theforces/Audio-Power-Amplifier/Layout/Layout.JPG

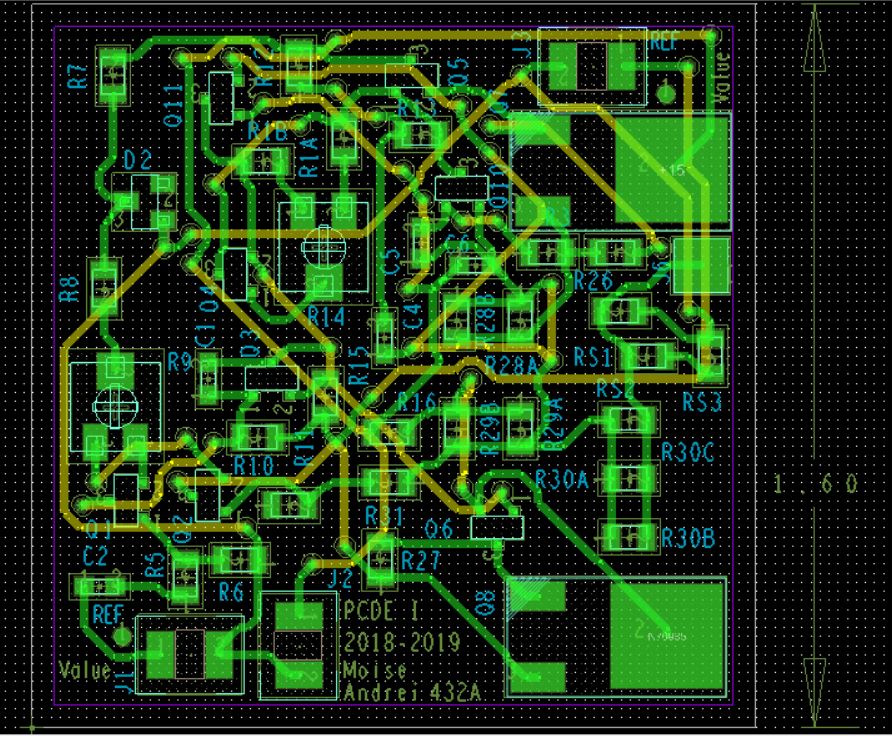
Layout/Layout.JPG
