theforces/Audio-Power-Amplifier/README.md

# Audio-Power-Amplifier

Faculty Project in Electronics.
