theforces/Audio-Power-Amplifier/Proiect.docx

PROIECT 1 – DISPOZITIVE ȘI CIRCUITE ELECTRONICE

MOISE ANDREI

432A

###### Cuprins

###### Capitolul 2

#### AMPLIFICATOR AUDIO DE PUTERE

  1. Tema de proiectare...............................................................................1
  2. Seturi de date de intrare........................................................................2
  3. Etajul final............................................................................................3
  4. Etajul pilot..........................................................................................10
  5. Etajul diferenţial.................................................................................14
  6. Reacţia negativă.................................................................................17
  7. Lista componentelor şi schema electrică...........................................18
  8. Analiza AC Sweep.............................................................................21
  9. Analiza Time Domain........................................................................22
  10. Analiza PSF........................................................................................23
  11. Modelul PCB......................................................................................24

#### AMPLIFICATOR AUDIO DE PUTERE

Acest capitol prezintă principalele aspectele ale proiectării amplificatoarelor audio de putere. Se porneşte de la o temă de proiectare care stabileşte schema bloc a amplificatorului şi principalii parametri ai amplificatorului. După proiectarea etajului final, pilot, diferenţial, a protecţiei termice şi la scurtcircuit sunt analizate stabilitatea şi amplificarea stabilită de reţeaua de reacţie negativă.

1 TEMA DE PROIECTARE

Tema de proiectare se referă la un amplificator de audiofrecvenţă de mare putere realizat dintr-un etaj de ieşire în clasă B polarizat cu ajutorul etajului pilot care lucrează în clasă A. Pentru asigurarea unui curent mare de ieşire tranzistoarele finale sunt realizate din două tranzistoare în conexiune darlington.

Amplificarea în tensiune şi adaptarea cu sursa de semnal de intrare este realizată cu ajutorul etajului de intrare de tip diferenţial care lucrează de asemenea în clasă A. Amplificarea globală a amplificatorului este stabilită prin intermediul reacţiei negative.

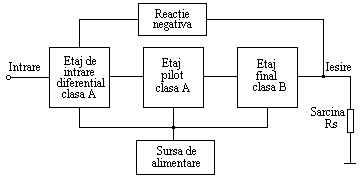
[picture p3: figure]

Figura 2.1 Schema bloc a amplificatorului audio de putere

2 SETURI DE DATE DE INTRARE

Principalii parametri ai amplificatorului audio de putere sunt:

- Puterea nominală pe sarcină PS (W)
- Rezistenţa de sarcină Rs (Ω)
- Rezistenţa de intrare Ri (KΩ)
- Amplificarea în tensiune Au (-)

Sursa de alimentare va asigura următorii parametri:

- Curentul nominal Io (mA)
- Rezistenţa de ieşire Ro (Ω)
- Coeficientul de stabilizare
- Tensiunea de alimentare este 220Vac ± 10%

Tabelul 2.1 Seturi de date de intrare pentru proiectare

Nr. | Amplificator | | | | Sursa de alimentare
| PS (W) | Rs (Ω) | Ri (KΩ) | Au (-) | IoM (A) | RoM (Ω)
16 | 10 | 8 | 45 | 8 | - | -

3 ETAJUL FINAL

Este realizat cu două tranzistoare bipolare complementare în conexiune colector comun. Deoarece tehnologia bipolară este axată pe tranzistore de putere de tip npn şi pentru creşterea amplificării în curent a etajului final se utilizează pentru cele două tranzistoare finale de putere configuraţii darlington de tip npn şi pnp.

Figura 2.2 Configuraţie darligton de tip npn

Considerăm T5 şi T7 în regim activ normal RAN.

VBE = VBE5 + VBE7 > 0

>0 >0

=> RAN

VCE = VCE7 = VCE5 + VBE7 > 0

Pentru ICB0 = 0 =>

Ic = Ic5 + Ic7 = βF5 Ib5 + βF7 Ib7 = βF5 Ib5 + βF7 Ie5 =

= = =

= =

≈ ≈

Principalii parametri ai configuraţiei Darlington de tip npn sunt:

βF ≈ βF7 βF5 = mare avantaj

== mare avantaj

VCE, Saturaţie = VCE2, Saturaţie = nemodificată avantaj

VBE = 2VBE5 = 2VBE7 = mare dezavantaj

Figura 2.3 Configuraţie darligton de tip pnp

Considerăm T1 şi T2 in RAN.

VEB = VEB6 > 0

=> RAN

VEC = VCE8 = VEC6 + VBE8 > 0

Pentru ICB0 = 0 =>

IC = IE8 = ( βF8 + 1 ) IB8 = ( βF8 + 1 ) IC6 =

= ( βF8 + 1 ) βF6 IB6 = ( βF8 + 1 ) βF6 IB

βF = (I_C)/(I_B) = ( βF8 + 1 ) βF6 ≈ βF8 βF6

Principalii parametri ai configuraţiei Darlington de tip pnp sunt:

βF ≈ βF8 βF6 = mare avantaj

h11 = h116 = nemodificat avantaj

VEB = VEB6 = nemodificat avantaj

VEC = VCE8 = VEC6 + VBE8 = mare dezavantaj

Când T6 se saturează se pierde controlul lui IC6 prin IB6 iar IC6 se închide prin joncţiunea BE a lui T8 care rămâne în RAN. =>

VEC, Saturaţie = VECT6, Saturaţie + VBET8 = 0,2 + 0,6 = 0,8V

Tehnologia bipolară standard este orientată pe fabricarea tranzistoarelor de tip npn care au conducţie verticală şi au factorul de amplificare în curent βF = mare (100 ÷ 200). Tranzistoarele pnp sunt de tip lateral cu conducţie orizontală sau tranzistor de substrat cu condiţie verticală având βF mic.

În practică se folosesc configuraţiile darlington cu rezistenţă în paralel cu joncţiunea bază-emitor a tranzistorului bipolar de putere de tip npn (R26 şi R27). Rolul acestor rezistenţe este următorul:

- La funcţionarea în clasă „B” în repaus curentul prin T7 este mic iar curentul de baza va fi şi el mic. La curenţi mici de colector amplificarea în curent a tranzistoarelor are o cădere pronunţată Þ amplificarea este redusă Þ reacţia negativă va fi ineficientă asupra neliniarităţii curbei de transfer. La îmbinarea caracteristicilor tranzistoarelor complementare apar distorsiuni de trecere (cross-over) şi pentru micşorarea acestora se face o polarizare iniţială în regim static al tranzistoarelor. Rezistenţa R26 măreşte curentul de colector al tranzistorului T5 în regim de repaus deoarece la IC7 mic ,h11T7 e foarte mare şi cea mai mare a curentului dat de T5 trece prin R26 si astfel T7 lucrează la curenţi acceptabili cu βF7 suficient de mare. La curenţi IC7 mari h11T7 scade exponenţial la creşterea curentului dat de T7 şi R26 se poate neglija.
- Rezistenţa R26 permite evacuarea sarcinii stocate prin circulaţia unui curent invers de bază în perioada corespunzătoare blocării Þ R26 îmbunătăţeşte funcţionarea la frecvenţe înalte dar nu elimină efectele dacă frecvenţa de lucru e mai mare ca fβ.

##### Puterea disipată de tranzistorii finali T7,T8

##### Puterea maximă ce se poate obţine la ieşire este:

##### P_0 =E_C ⋅I_(CM)

EC este tensiunea de alimentare pentru un tranzistor final

ICM este curentul de colector maxim al tranzistorilor finali

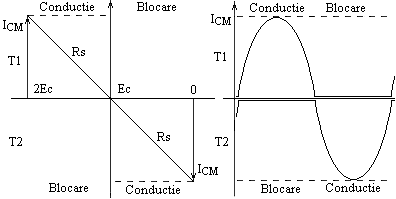
[picture p4: figure]

Figura 2.4 Diagramele de funcţionare a etajului final în contratimp

Puterea absorbită de la sursa de alimentare este:

P_a =2E_C ⋅I_(med)

Imed este curentul mediu absorbit de la sursă

Imed = = k

k este factorul de utilizare a tensiunii de alimentare

P_a =2E_C ⋅I_(med) =2E_C ⋅k⋅(I_(CM))/π=(2k)/π⋅P_0 =0,636⋅k⋅P_0

Puterea nominală pe sarcină are expresia:

P_S =1/2⋅R_S ⋅(k⋅I_(CM) )^2 =1/2⋅R_S ⋅k^2 ⋅I^2 _(CM) =0,5⋅k^2 ⋅P_0

RS este rezistenţa de sarcină

Puterea disipată de tranzistorii finali este:

P_(d(T_7 +T_8 )) =P_a -P_u =(0,636k-0,5k^2 )⋅P_0

Randamentul η=(P_S)/(P_a)=(0,5⋅k^2 ⋅P_0)/(0,636⋅k⋅P_0)=0,785⋅k

Derivând expresia puterii disipate de tranzistorii finali în raport cu k Þ puterea disipată maximă pe tranzistorii finali P_(dmax(T7+T8)) la k=0,636.

Pentru k=0,636 Þ

P_(dmax(T7+T8)) =[0,636^2 -0,5⋅(0,636)^2 ]⋅P_0 =0,2⋅P_0

Pentru un singur tranzistor final

P_(dmaxT7,T8) =1/2⋅(0,636⋅k-0,5⋅k^2 )⋅P_0 , pentru k=0.636 Þ

P_(dmaxT7,T8) =0,1⋅P_0

###### Dimensionarea componentelor etajului final

Pentru dimensionarea componentelor etajului final se impun condiţiile:

- Puterea nominală pe sarcină PS la o frecvenţă convenabilă, respectiv 1kHz (din setul de date utilizate pentru exemplificare PS =60)
- Impedanţa de sarcină nominală la 1kHz are caracter predominant rezistiv RS (din setul de date utilizate pentru exemplificare RS =4Ω)

1. Determinarea valorilor de vârf ale curentului şi tensiunii pe sarcină

P_S =(I_S 2 ⋅R_S)/2=(I_S ⋅U_S)/2⇒I_S =√((2⋅P_S)/(R_S))=√((2⋅10)/8)=1,58A

U_S =R_S ⋅I_S =8Ω⋅1,58A=12,64V≈12,65V

2. Se admite o pierdere de putere de maxim 10% pe rezistenţele de emitor R28 şi R29

R_28 =R_29 =0,47Ω < 0.1 X 8Ω

toleranţă ± 1%

Căderea maximă de tensiune pe R28, R29 este

U_(R_28) =U_(R_29) =R_28 ⋅I_S =0,47 ⋅ 1,58A = 0,74V

P_(dR28,R29) =(I_S ⋅U_(R_28))/4=0.29W (valoare medie, T7,T8 lucrează în clasă B). Se aleg R28 şi R29 de 0,5W (4x 0,125 W fiecare).

3. Se alege rezistenţa pentru circuitul de protecţie la suprasarcină

R_30 =0,157Ω U_(R30) =R_30 ⋅I_S =0,24V P_(dR30) =(Is⋅U_(R30))/2=0,195W

Se alege R30 de 0.375W (3x 0.125W fiecare).

4. Se aleg tranzistorii finali

S-a optat pentru tranzistori finali bipolari de putere de tip MJD31C având următorii parametri:

P_(tot) =15W UCE0,UCER = 100V I_C =3A

h21E = 25-50 (la IC=2A) UBE < 1V UCES = 1.2V

ft = 3Mhz

Ptot este puterea totală disipată

UCE0 este tensiunea colector emitor cu baza în gol

UCER este tensiunea colector emitor cu rezistenţă specificată între bază şi emitor

IC este curentul de colector

h21E este factorul de amplificare în curent static în conexiunea emitor comun

UBE este tensiunea bază emitor

UCES este tensiunea colector emitor în saturaţie

ft este frecventa de taiere minima

5. Verificarea la străpugere a trnzistorilor finali

EC ≤ 0,9UCER , EC = 15V ≤ 90= 0,9 VCER

6. Determinarea tensiunii reziduale pe darlingtonul npn

Urez = UCEST5 + UBET7max

În cazul cel mai defavorabil:

β_(T7,T8) =25⇒I_(BT7,T8) =(I_(CT7,T8))/(β_(T7,T8))=(I_S)/(β_(T7,T8))=(1,58A)/25=63,2mA

În funcţie de IBT7,T8 se aleg T5 şi T6 (BC846B, BC856B)

Pentru BC846B, UCEST5 ≈ 0,4V Þ Urez = 0,4 + 1= 1,4V

7. Determinarea tensiunii de alimentare

EC ≥ US + UR30 + UR28 + Urez = 14.66V = EC’

Se alege EC = 15V > EC’

8. Calculul energetic al tranzistorilor finali

P_0 =E_C ⋅I_(CM) =E_C ⋅I_S =23,7W k=(E^(') _C)/(E_C)=(14,66)/15=0,977 P_a =0,636⋅k⋅P_0 =14,72W P_S =1/2⋅k^2 ⋅P_0 =11,31W P_d =P_a -P_S =3,41W

(Puterea disipată pe T7 si T8 )

Puterea disipată pe un tranzistor final este maximă pentru k=0,636 este

P_(dmaxT_7) =P_(dmaxT_8) =0,1⋅P_0 =2,37W

În cazul nostru pentru k=0,977 puterea disipată pe un tranzistor final este

PdT7,T8 = 0,5 ( 0,636k – 0,5 k² ) P0 = 1,7W

η=0,785⋅k=0,766

9.Dimensionarea rezistenţelor R26 ,R27

Se aleg R26 ,R27 = 33Ω, toleranţă ± 1%

ICMT5 = IBMT7 + IR26 = IBMT7 + =63,2 mA + (1V)/(33Ω) ≈93,5mA<100mA

ICMT5 este curentul de colector maxim al tranzistorului T5

IBMT7 este curentul de bază maxim al tranzistorului T7

UBRMT7 este tensiunea bază emitor a tranzistorului T7

10. Estimarea sarcini dinamice pentru T5,T6

RST5 = [ h11T7 + βT7 ( RS + R30 + R28 ) ] ║ R_26

h11T7 = (U_(BEMT7))/(I_(BT7)) ≅ 15,82 Ω

RST5 = ( 15,82 + 25 · 8,39 ) ║ 33 = 28,78 Ω

11. Calculul energetic al tranzistorilor complementari

P0 = ICMT5 · EC = 0,0935· 15 = 1,4W

P0_(dmax) =0.1 P0 =0,14W

Tranzistoarele BC846B şi BC856B corespund, având următorii parametri:

I_C =0.1A I_(CM) =0.2A Ib=5mA T_j =150^0 C P_(tot) =0.25W f_T =100MHz R_(th,j-C) ≤100C/W

12. Calculul frecventei de taiere

ωt = β×ωβ

Pentru T7 si T8 fβ ≥ 222-500kHz

Pentru T5 si T6 fβ ≥ 222-454kHz

4 ETAJUL PILOT

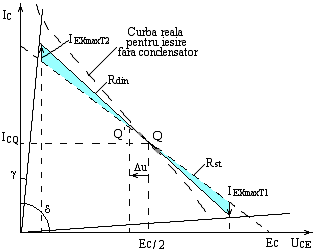
[picture p5: figure]

Figura 2.5 Configuraţia Figura 2.6 Caracteristica de ieşire

etajului pilot ale etajului pilot

Etajul pilot conform cu figura 2.5 este de tip emitor comun EC şi lucrează în clasa A. Pentru utilizarea completă a sursei de alimentare a circuitului de putere este necesară o tensiune de excitaţie vârf la vârf mai mare ca tensiunea de alimentare Uex,vv > EC, condiţie greu de realizat.

În figura 2.6 tgγ=R_(sat) si tgδ=R_(rez) , definite în raport cu ICER. Se observă că în cazul real excursia tensiunii Uex,vv este mult mai mică decât EC şi asimetrică.

K1 şi K2 sunt coeficienţii de utilizare ai tensiunii de alimentare pentru tranzistorul T1 respectiv pentru tranzistorul T2.

În schemele cu ieşire pe condensator, datorită inegalităţii dintre K1 şi K2 (în general K1 < K2) apar distorsiuni la nivele mari şi apare o componentă continuă ( Δu ) ce deplasează punctul static de funcţionare (PSF-ul) în sensul egalizării factorului de utilizare, figura 2.5. În schemele în care ieşirea nu se face pe condensator, ca în cazul acestui proiect, apare o curbură a caracteristicilor.

Soluţia poate fi folosirea unei tensiuni de alimentare a etajului pilot E_p >E_c , fapt ce conduce la complicarea surei de alimentare sau la soluţia de bustrapare a rezistenţei RC.

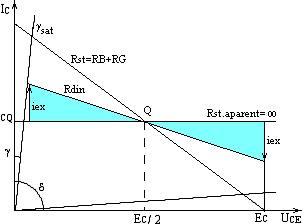
[picture p6: figure]

Figura 2.7 Bustraparea rezistenţei Figura 2.8 Caracteristica de ieşire

de colector a etajului pilot a etajului pilot butstrapat

Pentru acest montaj se poate considera:

- In regim static rezistenţa de alimentare este

R_(st) =R_c =R_B +R_G

- In regim dinamic ZS pentru etajul pilot este Rdin.
- In regim dinamic rezistenţa aparentă de alimentare este Rst a = ∞ şi sursa are valoarea E^(') _C =∞

Avantajele utilizării acestei soluţii sunt următoarele:

- Excursia curentului se limitează la

I_(VV) =2⋅I_(ex) <2⋅I_(CQ)

- Deoarece I_(CQ) >I_(ex) , această soluţie este avantajoasă pentru uşurarea regimului termic al etajului pilot.
- Se obţine astfel

k_1 ≈k_2

Condiţia de funcţionare a schemei este ca rezistenţa dinamică

R_(din) >R_C =R_B +R_G

###### Dimensionarea componentelor etajului pilot

1. Se calculează curentul de excitaţie maxim

I(I_(CT_5 max))/(β_(T_5 min) =(93,5mA)/220=0,425mA)BT_5 max_(exmax)

Se pot neglija curenţii reziduali şi se alege I_(CT3) =I_(CQ) =8mA > I_(exmax) =0,425mA

2. Rezistenţa statică de alimentare

R_C =R_B +R_G =R_13 +R_12 =(E_C)/(I_(CT_3))=(15V)/(8mA)=1,87KΩ

Alegem R_12 =910Ω si R_13 =1k

3. Sarcina dinamică a pilotului

R_(din) ≈(R_13 ⋅h_(11T_6))/(R_13 +h_(11T_6))+(1+h_(21E_f) ⋅(R_13)/(R_13 +h^(') _(11T_6)))(R_S +R_30 )

unde h11T6 = = 687,4Ω şi

h21Ef = h21T6 · h21T8 = 220· 25 = 5500

h^(') _(11T_6) =h_(11T_6) +(1+h_(21E_f) )⋅R_29 = 687,4+ ( 1+5500 ) · 0,47 = 3272,87Ω

Þ R_(din) =(1000⋅687,5)/(1687,5)+(1+5500⋅1/(1+3,2))⋅8.157≈11,09KΩ

Se verifică R_(din) =11,09kΩ>R_B +R_G =1,87KΩ

4. Tensiunea minimă pe tranzistorul pilot

5. Alegerea tranzistorului pilot

Pentru o funcţionare cât mai bună a botstrapului se alege un tranzistor cu UCEsat şi ICER mici.

Se alege BC846B cu parametri:

I_C =0,1A I_(CM) =0,2A T_j =150^0 C P_(tot) =0,25W f_T =100MHz R_(th,j-C) ≤100C/W

La I_C =2⋅I_(CQ) =16mA→U_(CEsat) =0,6V si I_(CER) =0,2mA

Tensiunea ce trebuie preluata de R15 este

U_(R_15) =UCEsat,T3_15 (U_(R_15))/(I_(CQ))(0,2V)/(8mA)_(p_(min))

Calculele impun alegerea lui R15 = 33Ω cu toleranţă de 1%

6. Curentul de baza al tranzistorului T3

Considerând h21E mediu,T3 = 280 Þ

I_(BT3) =(8mA)/280=28μA

7. Verificarea funcţionării la semnal mic

μ_(BE) =(I_C)/(g_m)=(I_(ex))/(40I_(CQ))= 0,0235V =23.5mV < 26mV = (KT)/q

8. Amplificarea în tensiune a etajului pilot

Etajul pilot este de tip emitor comun cu sarcină distribuită având amplificarea în tensiune:

A_(μp) ≈-(R_(din))/(R_15)=-(11,09k)/(33Ω)=-336,06

9. Calculul frecvenţei de tăiere

ω_T =β_0 ⋅ω_β ⇒ f_(βT_3) ≥0,25..0,625MHz

###### 10. Calculul circuitului de polarizare al tranzistorilor finali

Circuitul de polarizare este alcătuit din tranzistorul T4 ( superdiodă ) şi potenţiometrul R14. Se consideră necesar pentru deschiderea tranzistorilor finali o tensiune de 2 × 0,7V.

Pentru tranzistorul T4 alegem tipul QBC846B având următoarele valori limită absolute:

VCE0 =65V IC = 100mA IB = 5mA

Ptot = 250mW

În PSF tranzistorul T4 are următorii parametri:

I_(C,T4) =8mA U_(CE,T4) ≅1,4V⇒I_(B,T4) =(I_(C,T4))/(h_(21E,T4))≅(8mA)/220=36μA

Se alege prin divizorul de bază curentul:

I_d ≅0,5mA>>I_(B,T4) ⇒R_14 =R_1 +R_2 =(1,4V)/(0,5mA)=2,8kΩ

Se alege R14’ = 2,64kΩ.

R14’ = R1A + R1B + R14(potentiometru)

R14 = 2kΩ, R1A = 330Ω, R1B = 330Ω

5 ETAJUL DIFERENŢIAL

Etajul diferenţial este alcătuit din două tranzistoare în conexiune EC care lucrează în clasă A şi sunt cuplate diferenţial. Componentele acestui etaj sunt următoarele:

- Tranzistoarele T1 ,T2
- Rezistentele R6, R8, R9, R11, R31 şi D1, R7

Principalele funcţii ale acestui etaj sunt:

- Obţinerea unei impedanţe de intrare convenabile.
- Reglează echilibrarea stării de repaus (în absenţa semnalului) a întregului amplificator de putere
- Permite cuplarea reţelei de reacţie negativă

###### Dimensionarea componentelor etajului diferenţial

1. Alegerea tranzistoarelor T1,T2

Tranzistoarele T1, T2 se aleg de tipul BC856B şi se împerechează (se sortează două tranzistoare cu caracteristici cât mai apropiate). Aceste tranzistoare au următoarele valori limită absolute:

VCE0 =65V IC = 100mA IB = 5mA

Ptot = 250mW Tj = 175°C

2. Dimensionarea rezistenţei de colector a tranzistorului T1 (R11)

Se alege R_(CT_1) =R_11 <Z_(inT3min)

Z21cT_3 _15 11cT_3 min_(inT3min)

IB,T3max ≅ (2I_(CT3))/(ℎ_(21E mediu,T3)) = (2⋅8)/280 = 57µA

IC,T3min ≅ IB,T3max = 57µA Þ = 40 · IC,T3min = 2,3 Þ

h11,T3min = = 160/(2,3) = 69.5K ≅ 70K

Þ= 70K + 100·0,033K ≅ 103K

Pentru polarizarea bazei lui T3 trebuie ca :

(I_(C,T1) -I_(B,T3) )⋅R_11 =U_(BET3) +U_(R15) ≅ 0,7V + 8mA·33Ω ≅ 0,96V

Din motive de zgomot, pentru a avea factorul de zgomot F = 3dB trebuie ca:

ICT1 ≤ 300µA Se alege ICT1 = ICT2 = 250µA

Þ R_11 ≈(0,96)/(I_(C,T1) -I_(B,T3))=(0,96)/(250-57)=(0,96V)/(193mA)=4,9K

Se alege R11 = 5,6K cu toleranţă de ±1%.

3. Verificarea funcţionării la semnal mic

u_(BE,T1) =(i_(C,T1))/(g_(m,T1))=(i_(C,T1))/(40⋅I_(C,T1))=(80μA)/(40⋅250μA/V)=8mV

4. Determinarea tensiunii stabilizate de D1

Pentru a simula generatorul de curent din emitor trebuie ca tensiunea stabilizată U_z >>u_(BE,T1) . Deoarece I_(BT_1) e foarte mic se poate neglija tensiunea între bază şi masă.

Practic U_z =U_(R8) +U_(BE,T1) +U_(R6) ≈U_(R8) +U_(BE,T1)

Pentru ca R8 să se comporte ca un generator de curent continuu trebuie ca UR8 = ct, dar UBE,T1 variază cu uBE,T1 Þ tensiunea stabilizată de diodă trebuie să fie mult mai mare ca tensiunea bază emitor a tranzistorului T1, UZ >> UBE,T1.

Se alege UZ = 8,2V, astfel UZ ≅ 1000 · UBE,T1

Pentru tranzistorul T1 curentul de colector şi tensiunea colector emitor au valorile:

IC,T1 = 250µA şi U_(CE) ≈E_C =15V .

5. Dimensionarea rezistenţelor R6, R31

Se alege R6 = R31 = 47kΩ, ±5% având în vedere că în jurul acestei valori se va situa Zintr a întregului amplificator.

6. Dimensionarea rezistenţelor R9, R8

Pentru QBC856B din catalog se obţine h21E =220 Þ I_(B,T1) =(250μA)/220≈1μA .

Þ U_(R_6) =47mV . Considerând U_(BE,T1) ≈0,6V

Þ U_(1/2R9) +U_(R_8) =U_z -U_(BE,T1) -U_(R_6) =7,56V

Se alege pentru R9 o valoare de 500Ω şi atunci căderea de tensiune suplimentară pe jumătate din rezistenţa din emitorul lui T1 este :

U_(1/2R9) ≈I_(C,T1) ⋅1/2⋅R_9 =62,5mV Þ UR8 ≅ 7,5V

Curentul prin rezistenţa R8 este suma curenţilor de colector ai tranzistorilor T1, T2 IR8 = 2IC,T1 = 500µA Þ R_8 =(U_(R8))/(I_(R8))=(7,5V)/(0,5mA)=15K Ω, ±1%

7. Polarizarea diodei D1

Alegem o diodă zenner de tipul PL 8,2V care pentru o funcţionare normală trebuie polarizată la Iz =5mA.

R7 = (E_C -U_z)/(I_z +I_(R8))=(15V-8,2V)/(5,5mA) = 1,23KΩ

Se alege R7 = 1,5KΩ, ±1%

8. Determinarea amplificării etajului diferenţial

Amplificarea etajului diferenţial poate fi aproximată astfel:

A_(udif) ≅-(R_(Sdif))/(1/2R_9) unde RSdif este rezistenţa de sarcină a diferenţialului

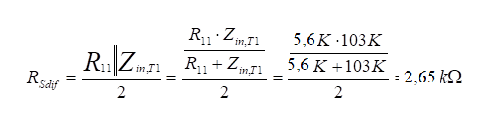
[picture p7: figure]

Þ A_(udif) ≅-2.65/(0,25) = -10.6 ≅ -11

6 REACŢIA NEGATIVĂ

Se apreciază un factor de transfer pe bucla de reacţie optim la frecvenţe medii:

β_r ≈(R_10)/(R_10 +R_31)≈1/10 (grad de reacţie ≈20dB )

Datorită divizoarelor protecţiei termice, tensiunea reală de intrare pe diferenţial este:

Uin,dif = D1 · D2 · Ugen

Unde: D1 = = 0,95 D2 = = 0,89

Se alege pentru Ugen = 1,5Vef Þ U_(in,dif) =0,95⋅0,89⋅1,5=1,3V_(ef)

Tensiunea nominală de ieşire este :

Un = = 0,7· IS· (RS + R30 ) = 0,7 · 1,58A · (8 + 0,157)Ω = 9,02V

Amplificarea cu reacţie este AUr = = (9,02)/(1,3) = 6,93 = = 1+

Þ = 5,93

Deoarece amplificarea în tensiune în buclă deschisă a amplificatorului de putere este dată de etajul pilot şi etajul diferenţial A_u ≈A_(up) ⋅A_(udif) =-126⋅(-11)=1386

Practic A_(ur) ≅1/(β_r) Þ R10 ≅ (R_31)/11=(47KΩ)/11=4,27KΩ

Se adoptă R10 = 4,7KΩ, ±1%

Frecvenţa limită pentru T1 şi T2 este fβ ≥ 400 ÷ 800KHz

7 SCHEMA ELECTRICĂ ŞI LISTA COMPONENTELOR

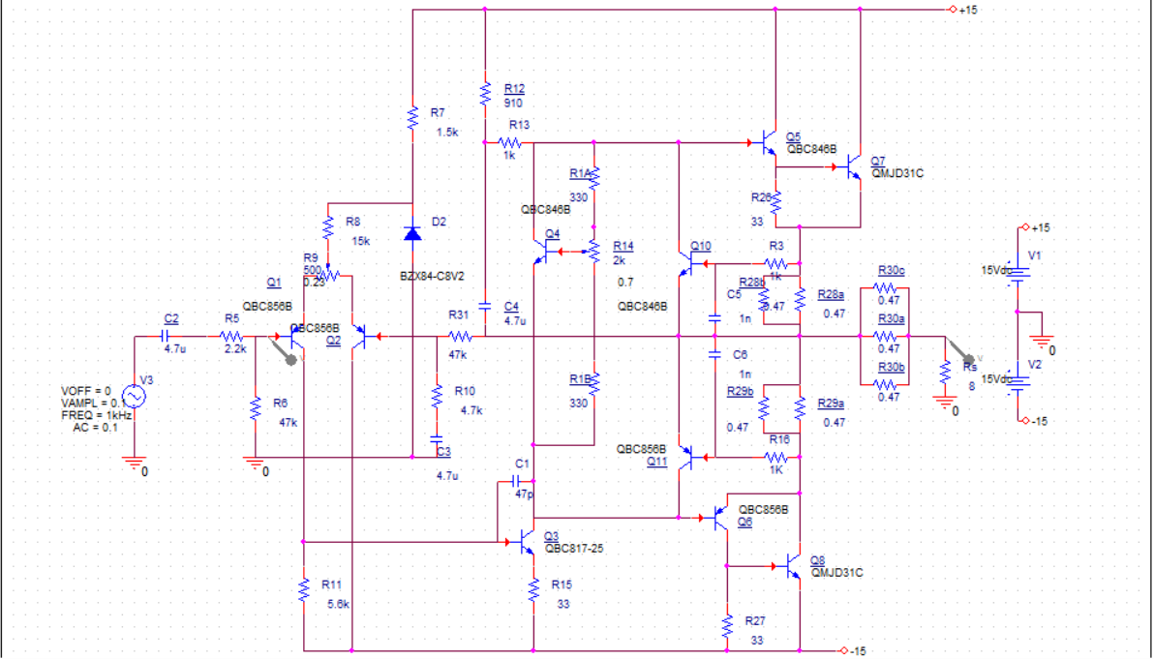
[picture p8: figure]

Figura 2.9 Schema electrică a amplificatorului audio de putere

###### Lista componentelor

Rezistenţe

R1A = 330 Ω, 1% R1B = 330 Ω, 1%

R3 = 1 K Ω, 1% R5 = 2,2 K Ω, 1%

R6 = 47 K Ω, 5% R7 = 1.5 K Ω, 1%

R8 = 15 K Ω, 1% R9 = 500 Ω, 10%

R10 = 4.7 K Ω, 5% R11 = 5.6 K Ω, 1%

R12 = 910 Ω, 5% R13 = 1 K Ω, 1%

R14 = 2 K Ω, 20% R15 = 33 Ω, 1%

R16 = 1 K Ω, 1% R26 = 33Ω, 1%

R27 = 33Ω, 1% R28a = 0,47Ω / 0.125W

R28b = 0,47Ω / 0.125W R29a = 0,47Ω/ 0.125W

R29b = 0,47Ω/ 0.125W R30a = 0,47Ω/ 0.125W

R30b = 0,47Ω/ 0.125W R30c = 0,47Ω/ 0.125W

R31 = 47 K Ω, 5%

Condensatori

C1 = 47 pF C2 = 4.7 μF

C3 = 4.7 μF C4 = 4.7 μF

C5 = 1 nF C6 = 1 nF

Tranzistori

Q1 = QBC856B Q2 = QBC856B

Q3 = QBC817-25 Q4 = QBC846B

Q5 = QBC846B Q6 = QBC856B

Q7 = QMJD31C Q8 = QMJD31C

Q10 = QBC846B Q11 = QBC856B

Diode

D2 = BZX84-C8V2

EC = 15 V

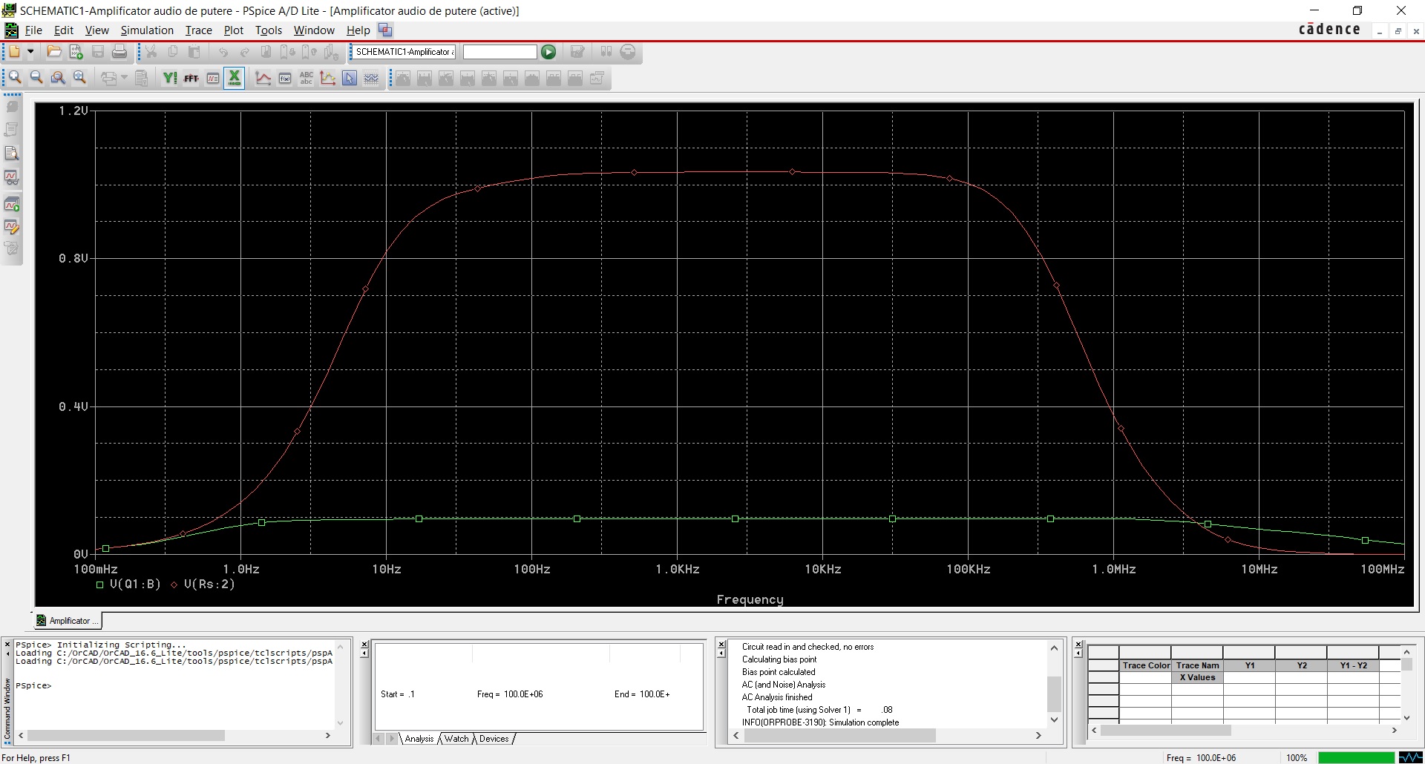
[picture p9: figure]

Figura 2.10 Răspunsul in frecvenţă al amplificatorului audio de putere (Analiza AC Sweep)

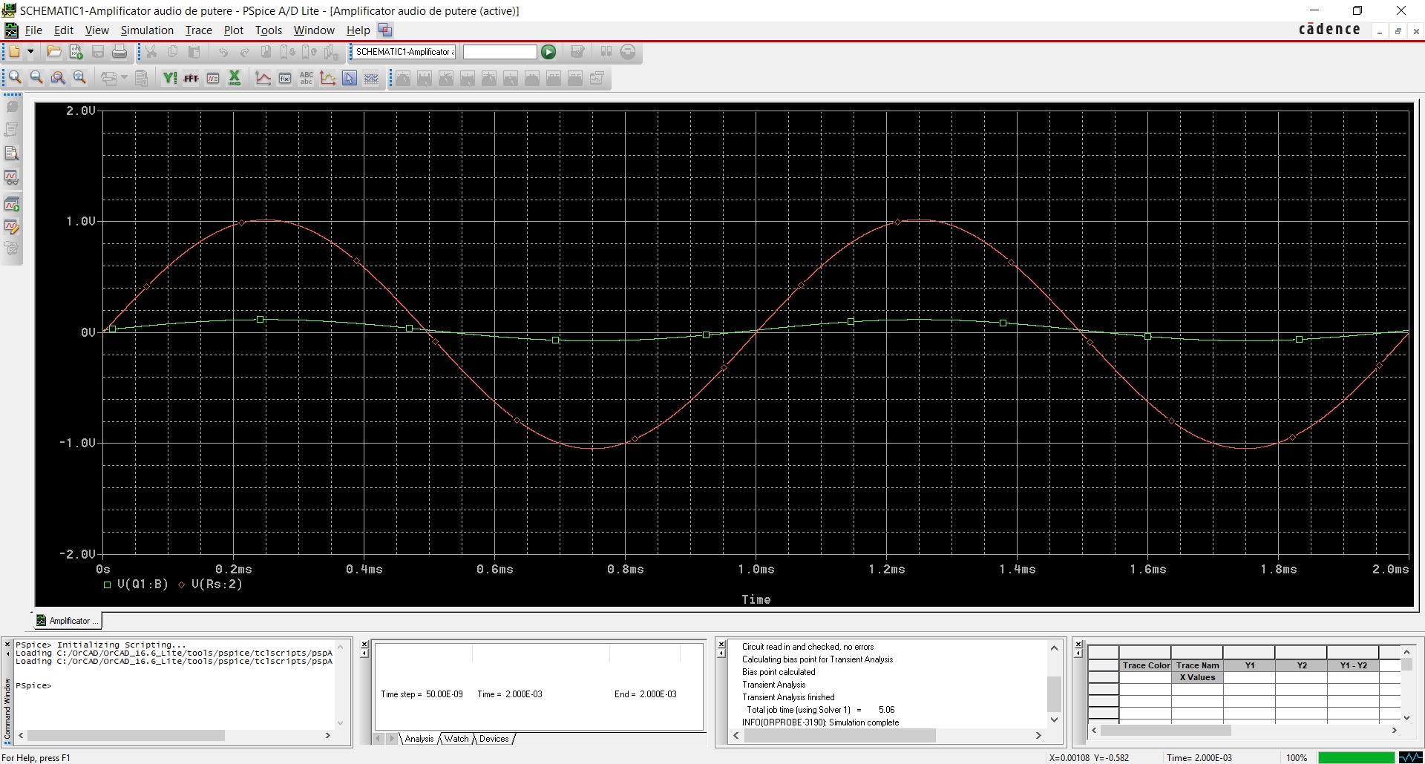
[picture p10: figure]

Figura 2.11 Analiza în domeniul timp (Time Domain)

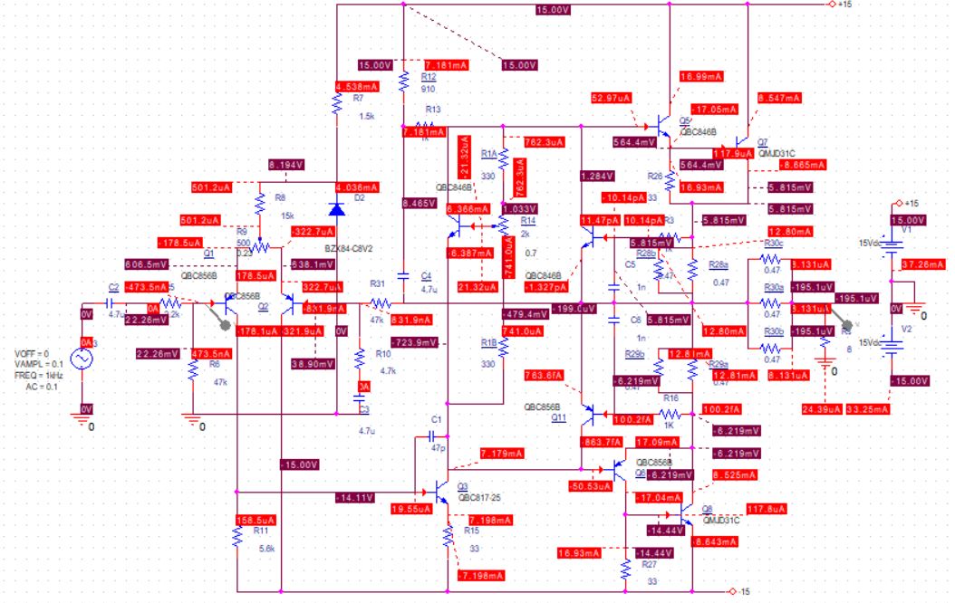
[picture p11: figure]

Figura 2.12 Analiza PSF a amplificatorului audio de putere


Figura 2.13 Modelul PCB
