theforces/Audio-Power-Amplifier/Tema16_Amplificator_de_putere.pdf

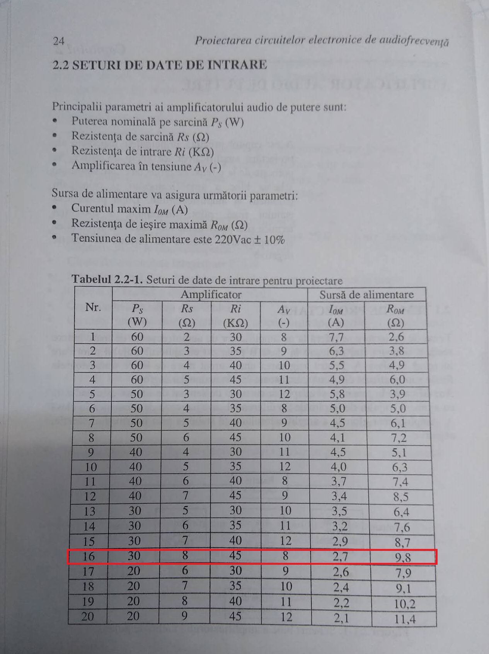
[picture p12: page 1]
