theforces/Audio-Power-Amplifier/Schematics/Schema.JPG

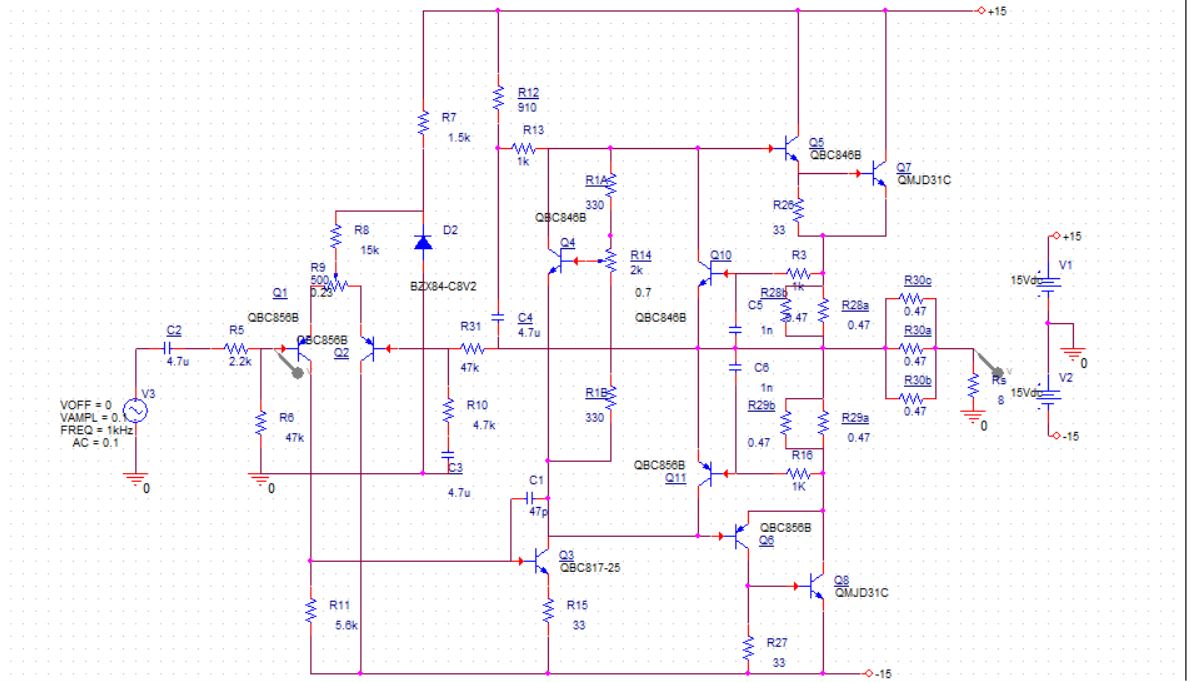
Schematics/Schema.JPG
