theforces/Audio-Power-Amplifier/Schematics/Amplificator audio de putere-PSpiceFiles/SCHEMATIC1/Amplificator audio de putere/Draft2.asc

D1: diode; 1N4148
D2: diode; 1N4148
R1: res; 1k
R2: res; 1k
R3: res; 1k
R4: res; 500
R5: res; 1k
U1: LT1001
U2: LT1001
V1: voltage; SINE(0 500m 10k)
Named nets: 0, VDD, VSS
.tran 0 5m 0 1u
