theforces/Audio-Power-Amplifier/(list of files, drawings)

Other design files:
Schematics/AMPLIFICATOR AUDIO DE PUTERE.DSN
Schematics/Amplificator audio de putere.opj
